msinger13480/mood-badge/README.md

# mood-badge
Part of the 2021 Milestones Intro to Electronics Pro workshop
