msinger13480/mood-badge/MoodBadge.docx

A small LED matrix on a keychain with multiple modes powered by a rechargeable battery. The matrix is set on a round board with a hole for a keychain ring. There are six total buttons, which function as up, down, left, right, select, and mode.

The first mode cycles through preset emojis, which change by pressing the left and right buttons. The user can also create custom emojis using the second mode, which allows the cursor to be moved with the up, down, left, and right buttons. The select button can then be used to toggle between the pixel under the cursor being lit or unlit. The next modes cycle through games that have yet to be decided but will probably include snake.
