msinger13480/mood-badge/MoodBadgeSketch.pdf

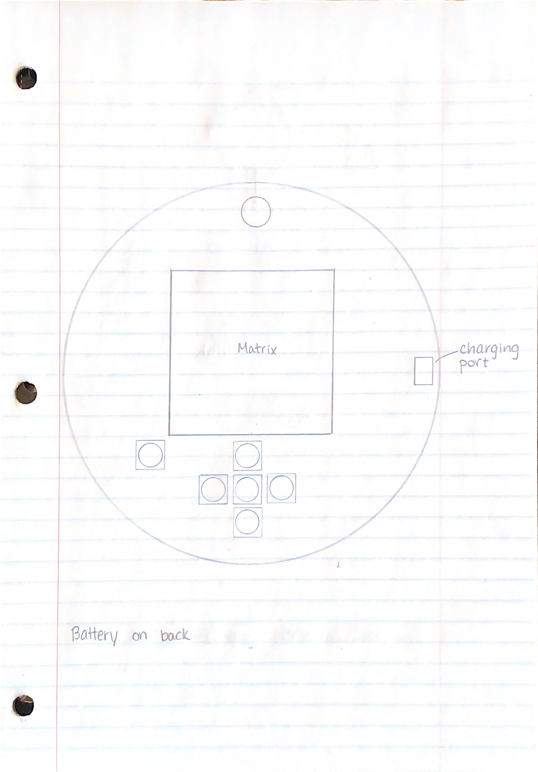
[picture p1: page 1]
