msinger13480/mood-badge/Hardware/MoodBadge-BOM.xlsx

Mood Badge -- V1 / Megan Singer |  |  |  |  |  |  |  |  |  |  | Total | $40.74 | Total (in Bulk) | $26.85
BOM # | Comment | Designator | Description | Mounting Type | Package | Manufacturer | Manufacturer Part Number | Supplier | Supplier Part Number | Price per unit | Quantity | Total | Per 100 | Total
1 | LM358 | OP1 | General Purpose Amplifier 2 Circuit 8-SOIC | SMD | 8-SOIC | Texas Instruments | LM358DR | Digi-Key | 296-1014-1-ND | $0.38 | 1 | $0.38 | $0.14 | $0.14
2 | Photoresistor | Photo | CDS Cell 520nm 27 ~ 60kOhms @ 10 lux | THT | Radial | Advanced Photonix | PDV-P8104 | Digi-Key | PDV-P8104-ND | $0.89 | 1 | $0.89 | $0.46 | $0.46
3 | 9V Battery Connector | 9V | Battery Connector, Snap 9V 1 Cell Wire Leads - 4" (101.6mm) | THT |  | Keystone Electronics | 81-4 | Digi-Key | 36-81-4-ND | $0.55 | 1 | $0.55 | $0.40 | $0.40
4 | White LED | LED1 | White LED Indication - Discrete 2.9V Radial | THT | Radial | American Bright Optoelectronics Corporation | BL-BZX3V4V-1-B02 | Digi-Key | BL-BZX3V4V-1-B02-ND | $0.26 | 1 | $0.26 | $0.09 | $0.09
5 | 10k resistor | R1,R2,R3 | 10 kOhms ±1% 0.1W, 1/10W Chip Resistor 0603 (1608 Metric) Automotive AEC-Q200 Thick Film | SMD | 0603 | Stackpole Electronics Inc | RMCF0603FT10K0 | Digi-Key | RMCF0603FT10K0CT-ND | $0.10 | 3 | $0.30 | $0.01 | $0.02
6 | 1uF capacitor | C1 | 1µF ±10% 25V Ceramic Capacitor X5R 0603 (1608 Metric) | SMD | 0603 | Samsung Electro-Mechanics | CL10A105KA8NNNC | Digi-Key | 1276-1102-1-ND | $0.10 | 1 | $0.10 | $0.02 | $0.02
1 | 100 nF capacitor | C2, C3, C4, C5, C6, C7, C15, C21 | CAP CER 1000PF 50V X7R 0603 | SMD | 0603 | Samsung Electro-Mechanics | CL10B102KB8NNNC | Digi-Key | 1276-1018-1-ND | $0.10 | 8 | $0.80 | $0.01 | $0.11
2 | 4.7 uF capacitor | C1, C8, C9, C16, C17, C18, | CAP CER 4.7UF 6.3V X5R 0603 | SMD | 0603 | Samsung Electro-Mechanics | CL10A475KQ8NNNC | Digi-Key | 1276-1045-1-ND | $0.10 | 6 | $0.60 | $0.02 | $0.12
3 | 2.2 uF capacitor | C10, C19 | CAP CER 2.2UF 6.3V X5R 0603 | SMD | 0603 | Samsung Electro-Mechanics | CL10A225KQ8NNNC | Digi-Key | 1276-1183-1-ND | $0.10 | 2 | $0.20 | $0.02 | $0.04
4 | 1 uF capacitor | C20 | CAP CER 1UF 25V X5R 0603 | SMD | 0603 | Samsung Electro-Mechanics | CL10A105KA8NNNC | Digi-Key | 1276-1102-1-ND | $0.10 | 1 | $0.10 | $0.02 | $0.02
5 | 0.1 uF capacitor | C11, C14 | CAP CER 0.1UF 25V X7R 0603 | SMD | 0603 | Samsung Electro-Mechanics | CL10B104KA8NNNC | Digi-Key | 1276-1006-1-ND | $0.10 | 2 | $0.20 | $0.01 | $0.03
6 | 22 pF capacitor | C12, C13 | CAP CER 22PF 50V C0G/NP0 0603 | SMD | 0603 | Samsung Electro-Mechanics | CL10C220JB8NFNC | Digi-Key | 1276-2228-1-ND | $0.10 | 2 | $0.20 | $0.02 | $0.04
7 | 205 ohm resistor | R16, R17, R18, R19, R20, R21, R22, R23 | RES 205 OHM 1% 1/10W 0603 | SMD | 0603 | Stackpole Electronics Inc | RMCF0603FT205R | Digi-Key | 738-RMCF0603FT205RCT-ND | $0.10 | 8 | $0.80 | $0.01 | $0.05
8 | 487 ohm resistor | R24 | RES 487 OHM 1% 1/10W 0603 | SMD | 0603 | Stackpole Electronics Inc | RMCF0603FT487R | Digi-Key | RMCF0603FT487RCT-ND | $0.10 | 1 | $0.10 | $0.01 | $0.01
9 | 1 kohm resistor | R2, R4, R6, R8, R10, R12, R13 | RES 1K OHM 5% 1/10W 0603 | SMD | 0603 | Stackpole Electronics Inc | RMCF0603JJ1K00 | Digi-Key | RMCF0603JJ1K00CT-ND | $0.10 | 7 | $0.70 | $0.01 | $0.04
10 | 10 kohm resistor | R1, R3, R5, R7, R9, R11, R14, R15, R26 | RES 10K OHM 1% 1/8W 0603 | SMD | 0603 | Stackpole Electronics Inc | RNCP0603FTD10K0 | Digi-Key | RNCP0603FTD10K0CT-ND | $0.10 | 9 | $0.90 | $0.02 | $0.21
11 | 12 kohm resistor | R25 | RES 12K OHM 5% 1/10W 0603 | SMD | 0603 | Stackpole Electronics Inc | RMCF0603JT12K0 | Digi-Key | RMCF0603JT12K0CT-ND | $0.10 | 1 | $0.10 | $0.01 | $0.01
12 | 210 kohm resistor | R28, R29 | RES 210K OHM 1% 1/10W 0603 | SMD | 0603 | Stackpole Electronics Inc | RMCF0603FT210K | Digi-Key | RMCF0603FT210KCT-ND | $0.10 | 2 | $0.20 | $0.01 | $0.01
13 | 3.3 Mohm resistor | R27 | RES 3.3M OHM 5% 1/10W 0603 | SMD | 0603 | Stackpole Electronics Inc | RMCF0603JT3M30 | Digi-Key | RMCF0603JT3M30CT-ND | $0.10 | 1 | $0.10 | $0.01 | $0.01
14 | Clock crystal | Y1 | CRYSTAL 16.0000MHZ 20PF TH | THT | HC-49/US | Raltron Electronics | AS-16.000-20-EXT | Digi-Key | 2151-AS-16.000-20-EXT-ND | $0.18 | 1 | $0.18 | $0.12 | $0.12
15 | Diode | D1, D2, D3 | DIODE SCHOTTKY 23V 1A SOD323 | SMD | SOD-323 | STMicroelectronics | BAT20JFILM | Digi-Key | 497-3381-1-ND | $0.35 | 3 | $1.05 | $0.15 | $0.46
16 | IR LED | LED8 | EMITTER IR 940NM 70MA SMD | SMD | 2-SMD, Z-Bend | Vishay Semiconductor Opto Division | VSMY2941RGX01 | Digi-Key | VSMY2941RGX01CT-ND | $0.61 | 1 | $0.61 | $0.41 | $0.41
17 | LED | LED1, LED2, LED3, LED4, LED5, LED6, LED7 | LED BLUE CLEAR CHIP SMD | SMD | 0603 | Lite-On Inc. | LTST-C191TBKT-5A | Digi-Key | 160-2212-1-ND | $0.33 | 7 | $2.31 | $0.12 | $0.82
18 | LED matrix | MATRIX | LED MATRIX 8X8 SQUARE GREEN | THT |  | Adafruit Industries LLC | 1623 | Digi-Key | 1528-2216-ND | $4.95 | 1 | $4.95 | $4.95 | $4.95
19 | Large push button | UP, DOWN, LEFT, RIGHT, SELECT, MODE | SWITCH TACTILE SPST-NO 1VA 32V | SMD |  | C&K | KT11P4SM34LFS | Digi-Key | CKN1860CT-ND | $3.62 | 6 | $21.72 | $2.75 | $16.47
20 | Small push button | RESET | SWITCH TACTILE SPST-NO 0.05A 12V | SMD |  | C&K | PTS830GG140 SMTR LFS | Digi-Key | CKN10588CT-ND | $0.59 | 1 | $0.59 | $0.48 | $0.48
21 | Switch | ON/OFF | SWITCH SLIDE DPDT 300MA 6V | SMD |  | C&K | JS202011JCQN | Digi-Key | CKN10723CT-ND | $0.55 | 1 | $0.55 | $0.44 | $0.44
22 | Bootloader 2x3 pins | BOOT | CONN HEADER VERT 6POS 2.54MM | THT |  | Sullins Connector Solutions | PREC003DAAN-RC | Digi-Key | S2012EC-03-ND | $0.18 | 1 | $0.18 | $0.10 | $0.10
23 | FTDI 1x6 pins | FTDI_DEVICE | PIN HEADER, THR, SINGLE ROW, .10 | THT |  | METZ CONNECT USA Inc. | PR20206VBNN | Digi-Key | 1849-PR20206VBNN-ND | $0.11 | 1 | $0.11 | $0.07 | $0.07
24 | USB port | USB1 | CONN RCPT USB2.0 MICRO B SMD R/A | SMD |  | Amphenol ICC (FCI) | 10118192-0001LF | Digi-Key | 609-4613-1-ND | $0.48 | 1 | $0.48 | $0.32 | $0.32
25 | LIPO battery port | LIPO | CONN HEADER SMD R/A 2POS 2MM | SMD |  | JST Sales America Inc. | S2B-PH-SM4-TB(LF)(SN) | Digi-Key | 455-1749-1-ND | $0.53 | 1 | $0.53 | $0.38 | $0.38
26 | Battery charger IC | CHRG |  | SMD |  |  | MCP73831 | Digi-Key |  |  | 1 | $0.00 |  | $0.00
27 | Port expander | IC1 |  | SMD | SO16W |  | PCF8574T | Digi-Key |  |  | 1 | $0.00 |  | $0.00
28 | Arduino ATMEGA328 | U2 |  | SMD | QFP |  |  | Digi-Key |  |  | 1 | $0.00 |  | $0.00
29 | Op amp | OP |  | SMD | SOT23-5 |  |  | Digi-Key |  |  | 1 | $0.00 |  | $0.00
30 | Transducer | PD |  | SMD | APDS9008 |  |  | Digi-Key |  |  | 1 | $0.00 |  | $0.00
