msinger13480/mood-badge/Hardware/board_outline_with_flat_edge.dxf

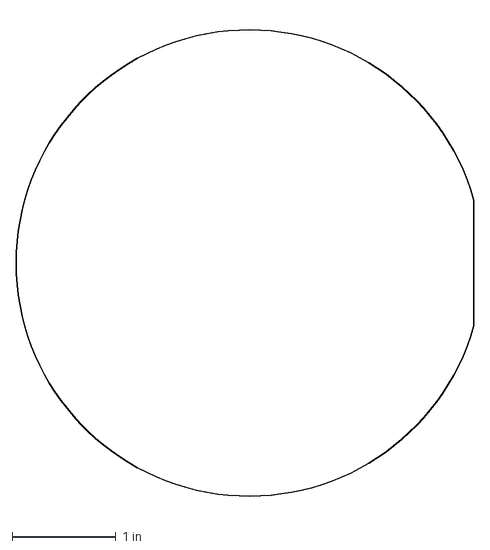
[picture p2: CAD file, 2021-03-20]
Hardware/board_outline_with_flat_edge.dxf
4.42 x 4.76 in
