msinger13480/mood-badge/Hardware/MoodBadge.brd

## EAGLE design Hardware/MoodBadge.brd (2021-03-27)

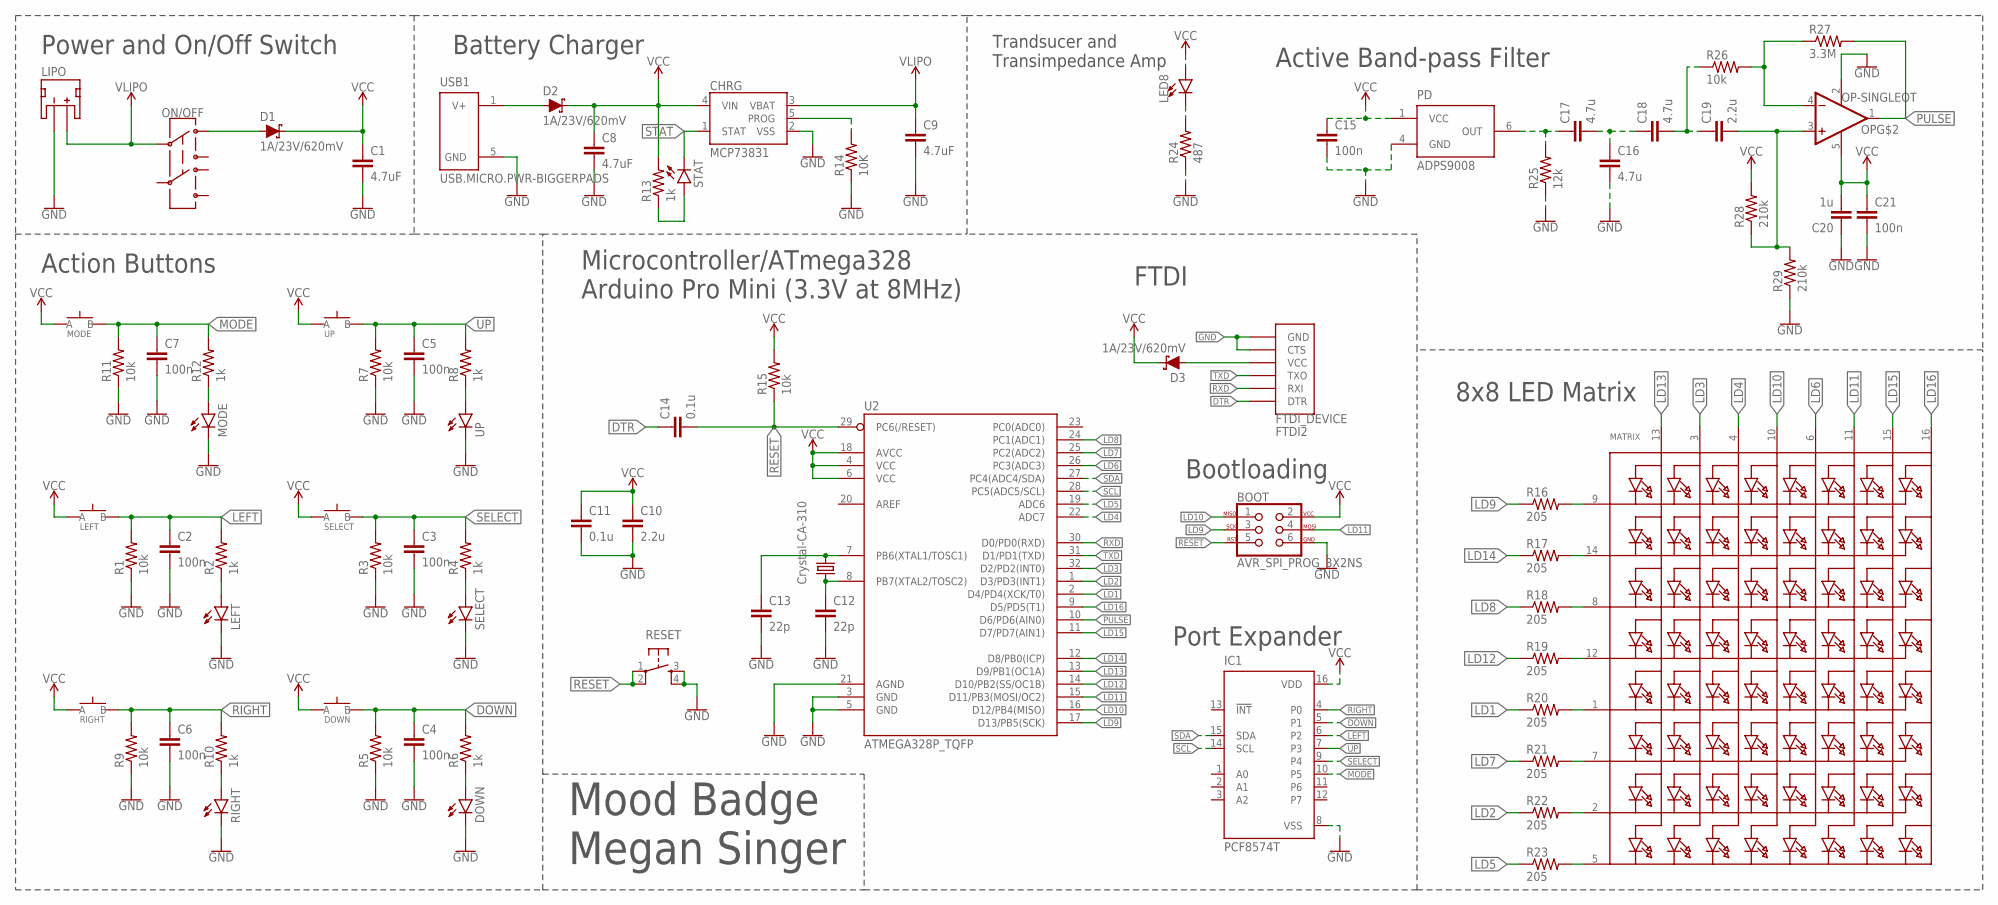
[picture p3: schematic MoodBadge.sch]

Parts:
BOOT: AVR_SPI_PROG_3X2NS; 2X3-NS
C1, C8, C9: 4.7uF; 0603
C2, C3, C4, C5, C6, C7: 100n; C0603
C10: 2.2u; C0603
C11, C14: 0.1u; C0603
C12, C13: 22p; C0603
C15, C21: 100n; 0603
C16, C17, C18: 4.7u; 0603
C19: 2.2u; 0603
C20: 1u; 0603
CHRG: MCP73831; SOT23-5
D1, D2, D3: 1A/23V/620mV; USC
DOWN: SPST.KT11P4SM34LFS
FTDI2: FTDI_DEVICE
IC1: PCF8574T; SO16W
LED1: LEFT; LED-0603
LED2: SELECT; LED-0603
LED3: DOWN; LED-0603
LED4: UP; LED-0603
LED5: RIGHT; LED-0603
LED6: MODE; LED-0603
LED7: STAT; LED-0603
LED8: LEDZ-BEND; 2-SMD.Z-BEND
LEFT: SPST.KT11P4SM34LFS
LIPO: JST_2MM_MALE; JST-2-SMD
MATRIX: SEGMENT_8X8_ROWCATHODEBL-M12A883; SEGMENT_BL-M12A883
MODE: SPST.KT11P4SM34LFS
ON/OFF: SWITCH.JS202011JXQNUPWARDS; SWITCH.00
OP: OP-SINGLEOT; SOT23-5
PD: ADPS9008; 6-PIN.CHIPLED
R1, R3, R5, R7, R9, R11, R15, R26: 10k; R0603
R2, R4, R6, R8, R10, R12, R13: 1k; R0603
R14: 10K; R0603
R16, R17, R18, R19, R20, R21, R22, R23: 205; R0603
R24: 487; R0603
R25: 12k; R0603
R27: 3.3M; R0603
R28, R29: 210k; R0603
RESET: SPST-PTS830GG140; BUTTON-GULLWING
RIGHT: SPST.KT11P4SM34LFS
SELECT: SPST.KT11P4SM34LFS
U2: ATMEGA328P_TQFP; TQFP32-08
UP: SPST.KT11P4SM34LFS
USB1: USB.MICRO.PWR-BIGGERPADS; USB-MICRO-01.BIGGERPADS.PWR
Y1: Crystal-CA-310; CA-301

Connections:
DOWN: C4.1, DOWN.3 (B), DOWN.4 (B), IC1.5 (P1), R5.2, R6.2
DTR: C14.1, FTDI2.DTR
GND: BOOT.6, C1.2, C2.2, C3.2, C4.2, C5.2, C6.2, C7.2, C8.2, C9.2, C10.2, C11.2, C12.2, C13.2, C15.2, C16.2, C20.1, C21.2, CHRG.2 (VSS), FTDI2.CTS, FTDI2.GND, IC1.8 (VSS), LED1.C, LED2.C, LED3.C, LED4.C, LED5.C, LED6.C, LIPO.1 (-), OP.2 (V-), PD.4 (GND), R1.1, R3.1, R5.1, R7.1, R9.1, R11.1, R14.1, R24.1, R25.1, R29.1, RESET.3, RESET.4, U2.3 (GND), U2.5 (GND), U2.21 (AGND), USB1.5 (GND)
LD1: R20.1, U2.2 (D4/PD4(XCK/T0))
LD2: R22.1, U2.1 (D3/PD3(INT1))
LD3: MATRIX.3 (A2), U2.32 (D2/PD2(INT0))
LD4: MATRIX.4 (A3), U2.22 (ADC7)
LD5: R23.1, U2.19 (ADC6)
LD6: MATRIX.6 (A5), U2.26 (PC3(ADC3))
LD7: R21.1, U2.25 (PC2(ADC2))
LD8: R18.1, U2.24 (PC1(ADC1))
LD9: BOOT.3, R16.1, U2.17 (D13/PB5(SCK))
LD10: BOOT.1, MATRIX.10 (A4), U2.16 (D12/PB4(MISO))
LD11: BOOT.4, MATRIX.11 (A6), U2.15 (D11/PB3(MOSI/OC2))
LD12: R19.1, U2.14 (D10/PB2(SS/OC1B))
LD13: MATRIX.13 (A1), U2.13 (D9/PB1(OC1A))
LD14: R17.1, U2.12 (D8/PB0(ICP))
LD15: MATRIX.15 (A7), U2.11 (D7/PD7(AIN1))
LD16: MATRIX.16 (A8), U2.9 (D5/PD5(T1))
LEFT: C2.1, IC1.6 (P2), LEFT.3 (B), LEFT.4 (B), R1.2, R2.2
MODE: C7.1, IC1.10 (P5), MODE.3 (B), MODE.4 (B), R11.2, R12.2
unnamed: D2.+ (A), USB1.1 (V+)
unnamed: D1.+ (A), ON/OFF.1
unnamed: LED1.A, R2.1
unnamed: CHRG.5 (PROG), R14.2
unnamed: LED2.A, R4.1
unnamed: LED7.A, R13.1
unnamed: LED3.A, R6.1
unnamed: C13.1, U2.7 (PB6(XTAL1/TOSC1)), Y1.2
unnamed: LED4.A, R8.1
unnamed: C12.1, U2.8 (PB7(XTAL2/TOSC2)), Y1.1
unnamed: LED5.A, R10.1
unnamed: D3.+ (A), FTDI2.VCC
unnamed: LED6.A, R12.1
unnamed: MATRIX.9 (K1), R16.2
unnamed: MATRIX.14 (K2), R17.2
unnamed: MATRIX.8 (K3), R18.2
unnamed: MATRIX.12 (K4), R19.2
unnamed: MATRIX.1 (K5), R20.2
unnamed: MATRIX.7 (K6), R21.2
unnamed: MATRIX.2 (K7), R22.2
unnamed: MATRIX.5 (K8), R23.2
unnamed: LED8.- (C), R24.2
unnamed: C17.1, PD.6 (OUT), R25.2
unnamed: C16.1, C17.2, C18.1
unnamed: C19.2, OP.3 (+IN), R28.1, R29.2
unnamed: C18.2, C19.1, R26.1
unnamed: OP.4 (-IN), R26.2, R27.1
PULSE: OP.1 (OUT), R27.2, U2.10 (D6/PD6(AIN0))
RESET: BOOT.5, C14.2, R15.1, RESET.1, RESET.2, U2.29 (PC6(/RESET))
RIGHT: C6.1, IC1.4 (P0), R9.2, R10.2, RIGHT.3 (B), RIGHT.4 (B)
RXD: FTDI2.TXO (RXI), U2.30 (D0/PD0(RXD))
SCL: IC1.14 (SCL), U2.28 (PC5(ADC5/SCL))
SDA: IC1.15 (SDA), U2.27 (PC4(ADC4/SDA))
SELECT: C3.1, IC1.9 (P4), R3.2, R4.2, SELECT.3 (B), SELECT.4 (B)
STAT: CHRG.1 (STAT), LED7.C
TXD: FTDI2.RXI (TXO), U2.31 (D1/PD1(TXD))
UP: C5.1, IC1.7 (P3), R7.2, R8.2, UP.3 (B), UP.4 (B)
VCC: BOOT.2, C8.1, C10.1, C11.1, C15.1, C20.2, C21.1, CHRG.4 (VIN), D2.- (C), D3.- (C), DOWN.1 (A), DOWN.2 (A), IC1.16 (VDD), LED8.+ (A), LEFT.1 (A), LEFT.2 (A), MODE.1 (A), MODE.2 (A), OP.5 (V+), PD.1 (VCC), R13.2, R15.2, R28.2, RIGHT.1 (A), RIGHT.2 (A), SELECT.1 (A), SELECT.2 (A), U2.4 (VCC), U2.6 (VCC), U2.18 (AVCC), UP.1 (A), UP.2 (A)
VLIPO: C1.1, C9.1, CHRG.3 (VBAT), D1.- (C), LIPO.2 (+), ON/OFF.2

Notes on the sheet:
Power and On/Off Switch
Action Buttons
Battery Charger
Microcontroller/ATmega328 Arduino Pro Mini (3.3V at 8MHz)
FTDI
Bootloading
8x8 LED Matrix
Trandsucer and Transimpedance Amp
Active Band-pass Filter
Port Expander
Mood Badge Megan Singer

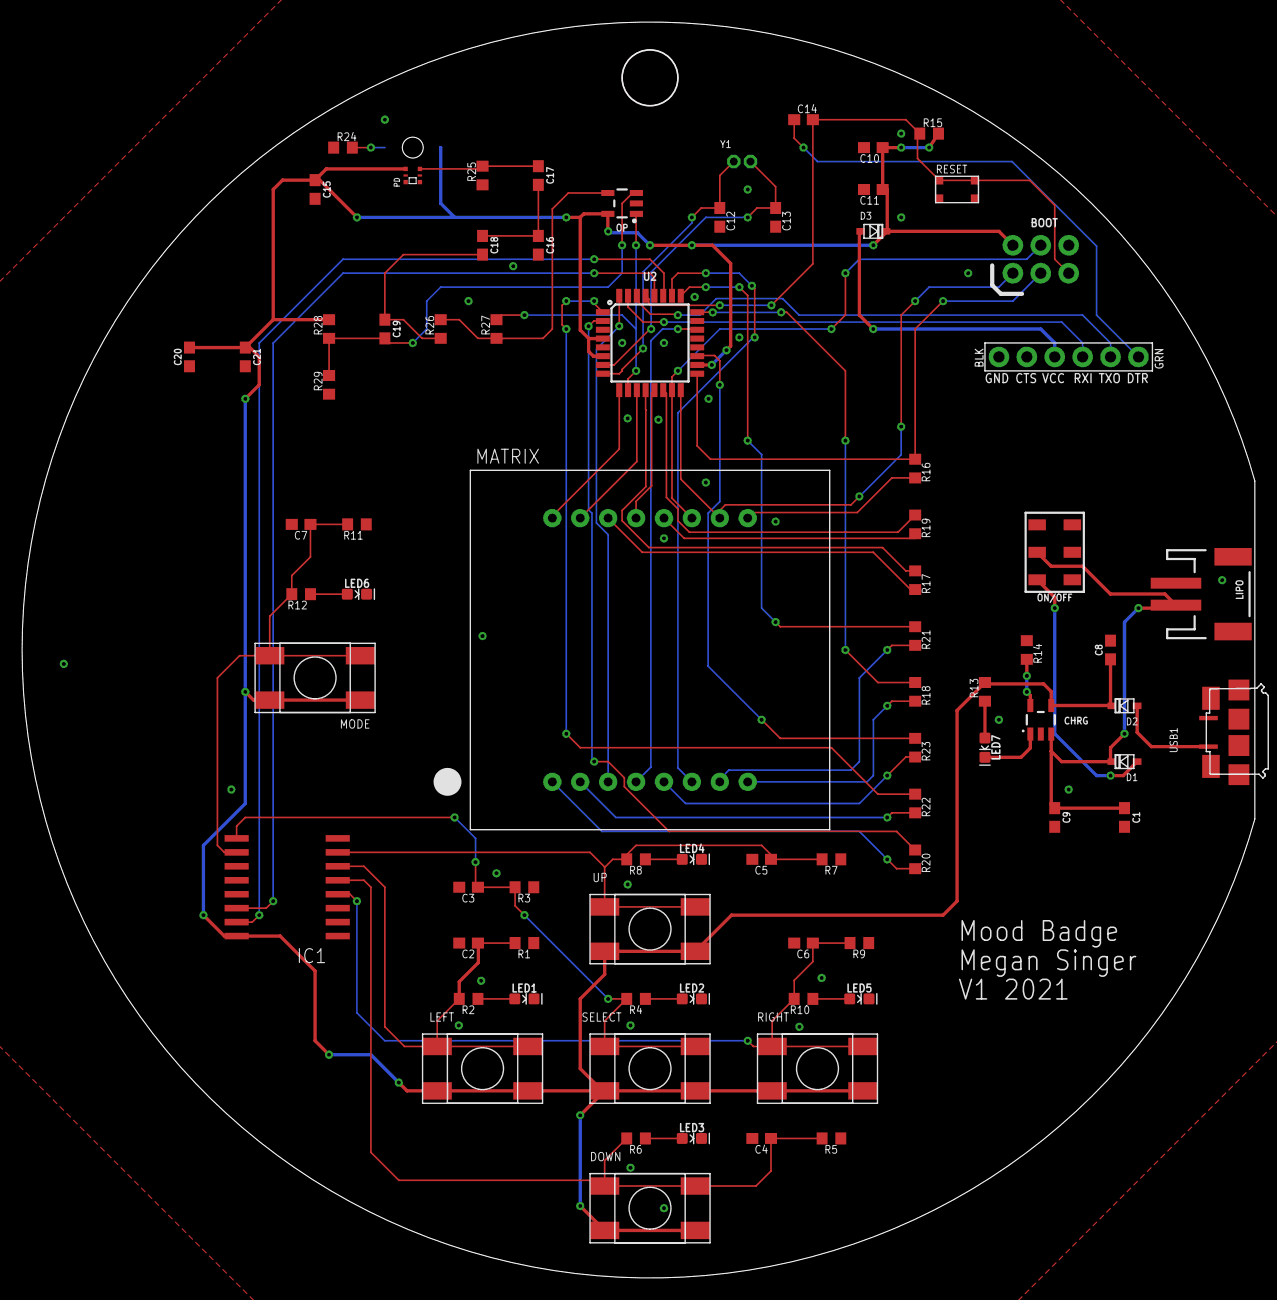
[picture p4: board MoodBadge.brd from above]

Board: 2 copper layers, 112.2 x 114.3 mm, 80 parts (1 on the bottom side), 60 nets.
