msinger13480/mood-badge/(commit log)

2021-02-20 bill of materials
    [Milestones-BOM-Template.xlsx]
2021-02-20 updated BOM file name
    [MoodBadge-BOM.xlsx]
2021-02-27 EAGLE files
    [MoodBadge.brd, MoodBadge.sch]
2021-02-27 updated BOM file location
    [MoodBadge-BOM.xlsx]
2021-02-27 changed file location
    [MoodBadge.brd]
2021-03-06 Created board outline and started schematic
    [MoodBadge.brd, MoodBadge.sch]
2021-03-13 Added battery charger and microcontroller sections
    [MoodBadge.brd, MoodBadge.sch]
2021-03-13 Added LED matrix and fixed Arduino output pins
    [MoodBadge.brd, MoodBadge.sch]
2021-03-13 Added remaining parts of circuit and port expander. Connected Pulse pin
    [MoodBadge.brd, MoodBadge.sch]
2021-03-13 Fixed incorrect values and made organizational adjustments
    [MoodBadge.brd, MoodBadge.sch]
2021-03-13 Added title block
    [MoodBadge.sch]
2021-03-13 Placed the matrix and the direction buttons
    [MoodBadge.brd]
2021-03-13 Initial placement of components
    [MoodBadge.brd]
2021-03-20 Began routing traces and added flat edge to board outline
    [board_outline_with_flat_edge.dxf]
2021-03-20 Continued routing and changed a few pins for easier routing
    [MoodBadge.brd, MoodBadge.sch]
2021-03-20 Edited copper pour outline for easier visibility
    [MoodBadge.brd]
2021-03-27 Finished creating traces and filled copper pour
    [MoodBadge.brd]
2021-03-27 Adjusted trace width and ran DRC
    [MoodBadge.brd, MoodBadge.sch]
2021-03-27 Fixed labeling error for FTDI pins
    [MoodBadge.brd, MoodBadge.sch]
2021-03-27 Added ground plane vias
    [MoodBadge.brd, MoodBadge.sch]
2021-03-27 Finished adding ground plane vias
    [MoodBadge.brd]
2021-03-27 Changed heart rate LED to IR LED and moved closer to the photoresistor
    [MoodBadge.brd, MoodBadge.sch]
2021-03-27 Listed all part names and designators
    [MoodBadge-BOM.xlsx]
2021-04-03 Completed a majority of the BOM. Missing 5 components
    [MoodBadge-BOM.xlsx]
